olutsen1/IDOmeter/software/README_uk.md

# IDOmeter — програма: посібник користувача

Приймання даних із приладу (або симулятора), графіки в реальному часі, мітки
інтервенцій клавішами, запис сесії та аналіз відповідей на мітки. Усе працює на
одному комп'ютері: без Raspberry Pi, MQTT-брокера і Grafana.

## Встановлення (один раз)

1. Встановіть Python 3.11 або новіший з python.org. Якщо інсталятор пропонує
   галочку **«Add python.exe to PATH»**, поставте її.
2. Запустіть `1_install.bat`.

**Linux (Ubuntu/Debian):** відкрийте термінал у теці `software/` і один раз
виконайте `./1_install.sh` (може запитати пароль, щоб встановити два системні
пакети). Далі замість `.bat` використовуйте `./2_demo_with_simulator.sh`,
`./3_receiver_real_device.sh` і `./4_analyze_last_session.sh`. Якщо увімкнено
брандмауер `ufw`, відкрийте порт приладу: `sudo ufw allow 5005/udp`.

## Спробувати без приладу

Запустіть `2_demo_with_simulator.bat`. Відкриються два вікна: консоль симулятора
і програма. Якщо Windows запитає про доступ Python до мережі, дозвольте для
приватних мереж.

Натисніть **R** (запис), потім ставте мітки клавішами **1…9**, **Пробіл**, **B**.
Симулятор з імовірністю 80 % «відповідає тілом»: через 1–2,5 с зростає
провідність шкіри, пульс сповільнюється, а потім пришвидшується, іноді —
глибокий вдих. Він також видає спонтанні відповіді, не пов'язані з мітками,
як справжнє тіло, і приблизно раз на дві хвилини — рух пальця (`--motion`, за хвилину).

## З приладом

Як залити прошивку — у `..\firmware\HOW_TO_FLASH_uk.md`. Потім запускайте
`3_receiver_real_device.bat`.

## Клавіші

| Клавіша | Дія |
|---|---|
| 1…9, Пробіл, B | мітка відповідного типу |
| N | нотатка: час фіксується в момент натискання N, далі пишете текст, Enter |
| Esc | скасувати нотатку |
| R | старт / стоп запису |
| F | заморозити прокручування (тоді графіки можна гортати мишею) |

Мітки, поставлені до натискання R, видно на графіках, але у файл вони не потрапляють.

## Аналіз

```
python analyze.py sessions\<тека>
python analyze.py sessions\<тека> --truth sim_truth.csv     (перевірка на симуляторі)
```

Результати — у `sessions\<тека>\analysis`: `overview.png` (уся сесія),
`responses.png` (відповіді, накладені за типами міток) і `responses.csv`.
Аналіз також рахує **випадковий рівень**: як часто «відповідь» трапляється у
вікнах без міток. Про ефект можна говорити лише тоді, коли частка відповідей на
мітки помітно вища за нього.

## Мова і назви міток

Мова задається в `config.json`: `"language": "en"` або `"language": "uk"`.
Відкрийте файл Блокнотом і змініть значення. Тексти лежать у теці `lang`.
Щоб додати мову, скопіюйте `lang/en.json`, наприклад, у `lang/de.json`,
перекладіть значення (залишаючи `{заповнювачі}`) і вкажіть `"language": "de"`.

Власні назви міток: додайте до `config.json`
`"markers": {"1": "Питання", "2": "Відображення", ...}`. Якщо цього розділу
немає, беруться стандартні назви вибраної мови.

## Артефакти пульсу

Якщо палець зрушив або датчик притиснули, удар може бути розпізнано хибно, і
пульс стрибає на одну точку (наприклад, 55 → 93 → 52). Такі інтервали
відкидаються: кожен міжударний інтервал порівнюється із середнім двох сусідніх,
і найбільш відмінний відкидається, якщо різниця понад 30 %; перевірка
повторюється, доки таких не залишиться. Справжні зміни, навіть великі (реакція
переляку, коливання ±20 уд/хв під час повільного глибокого дихання), змінюються
поступово від удару до удару і зберігаються — це перевірено на синтетичних
випадках. Відкинутий удар видно як розрив лінії пульсу, а не як вигадане
значення. Сира PPG завжди записується повністю, а аналіз показує, скільки
інтервалів відкинуто; понад 10 % — попередження про поганий контакт датчика.

## Артефакти руху

Рух пальця або натиск на датчик видно в пульсовій хвилі як короткий сплеск,
набагато більший за звичайний (або як майже зникнення пульсу). Такі відрізки
зафарбовуються сірим на всіх графіках, а в панелі стану з'являється «рух».
Усередині них пульс і крива дихання з PPG не показуються, і вони не входять у
частоту дихання та у відповідь пульсу навколо міток. Провідність шкіри від цього
не залежить. Сирі дані записуються повністю; аналіз показує, скільки було
артефактів і якої тривалості, зафарбовує їх в `overview.png` і додає до
`responses.csv` стовпець `motion_s` (секунди руху у вікні кожної мітки).

Виявлення: локальний розмах пульсової хвилі (1,5 с) понад 3× або менше 0,15× від
його медіани за навколишню хвилину, **або** удар, форма якого корелює з типовою
формою сусідніх ударів менше ніж на 0,6 (легкий рух спотворює пульс, не
збільшуючи його), **або** сходинка базової лінії за два удари, більша за 2,5
розмаху пульсу (зміна тиску пальця); з розширенням на 1,5 с до і 2,5 с після.
Перед будь-якою обробкою поодинокі збої сирої PPG завдовжки 1–2 відліки
прибираються медіаною 50 мс (у запис потрапляють сирі значення). Пороги підібрано на
реальних записах так, щоб глибокі вдихи не позначалися (вони зсувають базову лінію
до 2,2 розмаху пульсу); із шести навмисних рухів пальцем позначено чотири, один не
залишив помітного сліду, ще один був легкою зміною тиску, що не заважає пульсу.
Нижня межа навмисно мала: після глибокого вдиху пульс пальця в нормі зменшується
до ~40 % на кілька секунд, і це фізіологія. Перевірка на симуляторі: усі рухи
виявлено; 5 хвилин з 10 глибокими вдихами без руху — жодної хибної смуги.

## Дихання без датчика

Якщо прилад не надсилає канал дихання (на нинішній платі його немає), графік
«Дихання» показує дихання, **оцінене за пульсовою хвилею** (з позначкою «з PPG»),
а панель стану — частоту дихання. Кожен вдих зсуває базову лінію PPG пальця;
`breathing.py` виділяє цей ритм (8–36 вдихів за хвилину). Видно ритм, паузи й
глибокі вдихи, але не об'єм дихання; чи йде вдих угору, чи вниз, залежить від людини.

**Частота** дихання рахується вдих за вдихом у трьох сигналах і зводиться
разом: зсув базової лінії, пульс (на вдиху він зростає) та амплітуда пульсової
хвилі. Два останні не залежать від повільного дрейфу базової лінії. На
синтетичних даних похибка близько 1 вдиху за хвилину; дихання, повільніше за
~8 за хвилину, — на межі діапазону й оцінюється завищено. Якщо три сигнали не
узгоджуються, замість частоти показується «—».

`"breathing_source"` у `config.json`: `"auto"` (типово: датчик, якщо є, інакше PPG),
`"sensor"` або `"ppg"`. Аналіз показує частоту дихання з PPG, а за наявності
датчика — наскільки вони збігаються.

## Калібрування EDA

### Калібрування резисторами (з підказками)

Залийте на плату `tools/board_check`, закрийте Serial Monitor в Arduino IDE і
запустіть `5_calibrate.bat` (Linux: `./5_calibrate.sh`). Програма сама знайде
порт плати, підкаже, який резистор під'єднати (1 МОм, 470 кОм, 220 кОм,
100 кОм, 47 кОм), запише кожен автоматично і збереже все в
`calibration/<дата_час>/` (`summary.csv`, `samples.csv`, сирий вивід плати і
текст з екрана). На запиті можна ввести виміряне значення резистора в кОм,
`s` — пропустити, `q` — завершити. У Linux для доступу до порту може знадобитися
один раз `sudo usermod -a -G dialout $USER` (потім вийти й увійти).

У `config.json`, розділ `eda_calibration`:

- `{"type": "relative", "full_scale": 65520, "invert": true}` — типово для
  Grove GSR: 0–100 відносних одиниць, угору = провідність зростає;
- `{"type": "table", "points": [[сире, мкСм], ...]}` — після калібрування на резисторах;
- `{"type": "linear", "gain": 0.001, "offset": 0}` — автоматично з симулятором.

## Файли

| Файл | Призначення |
|---|---|
| `protocol.py` | формат пакета (прошивка реалізує той самий) |
| `clocksync.py` | зведення годинників приладу і комп'ютера |
| `simulator.py` | симулятор приладу (`python simulator.py --help`) |
| `receiver.py`, `receiver_core.py` | програма |
| `analyze.py` | аналіз сесії |
| `i18n.py`, `lang/` | мови інтерфейсу |
| `config.json` | налаштування |

Сесія — це тека з `fast.csv` (PPG 100 Гц), `slow.csv` (EDA і дихання 20 Гц),
`markers.csv`, `packets.csv` (для точного перерахунку часу) і `meta.json`.
Усе відкривається в Excel або Python.

## Як влаштований час

Прилад не знає реального часу. Кожен пакет має номер і показ власного лічильника
мікросекунд. Програма фіксує момент надходження пакета і за **нижньою обвідною**
затримок будує пряму «час приладу → час комп'ютера» з урахуванням дрейфу кварцу.
Мітки ставляться за годинником комп'ютера, тож сигнали й мітки лежать на одній
шкалі з точністю до мілісекунд.
