olutsen1/IDOmeter/software/simulator.py

"""
IDometer device simulator ("a body in a box").

Generates realistic signals and sends them using protocol v1 (protocol.py),
just as the real device does:

  * skin conductance: a slow tonic level + phasic responses (SCRs),
    including spontaneous ones unrelated to any event;
  * PPG (MAX30102, IR and red) with heart rate, respiratory arrhythmia and noise;
  * breathing.

It also imitates the real device's imperfections: its own clock with drift
and a random initial offset, Wi-Fi delays and stalls, packet loss.

Most importantly, the simulator listens for the receiver's markers (port 5006)
and, with a given probability, "responds bodily": an SCR 1–2.5 s later, a heart
rate dip then rise, sometimes a deep breath. All planted responses are written
to sim_truth.csv in DEVICE time, so the analysis can check whether it finds
what was planted.

Run:  python simulator.py
         python simulator.py --help
"""
import argparse
import csv
import heapq
import math
import queue
import random
import socket
import threading
import time

import numpy as np

import i18n
import protocol as P
from i18n import tr


# ---------------------------------------------------------------- physiology

def _bateman_peak(tr, td):
    xs = np.linspace(0, 20, 20001)
    return float(np.max(np.exp(-xs / td) - np.exp(-xs / tr)))


class Body:
    TAU_RISE = 0.75
    TAU_DECAY = 2.5

    def __init__(self, rng: random.Random, spont_per_min=2.0, motion_per_min=0.0):
        self.rng = rng
        self.spont_rate = spont_per_min / 60.0
        self._norm = _bateman_peak(self.TAU_RISE, self.TAU_DECAY)
        self.tonic = 5.0
        self.tonic_target = 5.0
        self.scrs = []                  # (onset_s, amp_uS)
        self.hr_events = []             # onset_s
        self.sighs = []                 # onset_s
        self.motion_rate = motion_per_min / 60.0
        self.motion = []                # (onset_s, duration_s, amplitude, frequency_hz)
        self.resp_phase = 0.0
        self.resp_rate = 14.0
        self.hr_noise = 0.0
        self.ppg_drift = 0.0            # slow baseline wander of the finger PPG
        self.beats = []
        self.next_beat = None
        self.new_beats = []             # for the log
        self.t_last = None

    # --- events
    def add_scr(self, onset, amp):
        self.scrs.append((onset, amp))

    def add_hr_response(self, onset):
        self.hr_events.append(onset)

    def add_sigh(self, onset):
        self.sighs.append(onset)

    # --- components
    def _bateman(self, x):
        if x <= 0:
            return 0.0
        return (math.exp(-x / self.TAU_DECAY) - math.exp(-x / self.TAU_RISE)) / self._norm

    def eda(self, t):
        v = self.tonic
        for on, a in self.scrs:
            v += a * self._bateman(t - on)
        return v

    def _hr(self, t):
        hr = 68.0 + self.hr_noise + 4.0 * math.sin(self.resp_phase)
        for on in self.hr_events:
            x = t - on
            hr += -3.0 * math.exp(-0.5 * ((x - 1.5) / 0.7) ** 2)
            hr += 6.0 * math.exp(-0.5 * ((x - 5.0) / 1.6) ** 2)
        return hr

    def _resp_amp(self, t):
        a = 1.0
        for on in self.sighs:
            a += 0.9 * math.exp(-0.5 * ((t - on - 1.5) / 1.2) ** 2)
        return a

    @staticmethod
    def _pulse(x):
        if x < 0 or x > 1.0:
            return 0.0
        return (math.exp(-0.5 * ((x - 0.18) / 0.055) ** 2)
                + 0.35 * math.exp(-0.5 * ((x - 0.42) / 0.07) ** 2))

    # --- 10 ms step
    def _motion(self, t):
        """Finger movement: a burst much larger than the pulse, plus a baseline push."""
        m = 0.0
        for on, dur, a, f in self.motion:
            x = t - on
            if 0 <= x <= dur:
                env = math.sin(math.pi * x / dur)
                m += a * env * (math.sin(2 * math.pi * f * x) + 0.5)
        return m

    def _vasoconstriction(self, t):
        """After a deep breath the finger pulse shrinks to ~45 % for several seconds."""
        v = 0.0
        for on in self.sighs:
            v += 0.55 * math.exp(-0.5 * ((t - on - 6.0) / 2.5) ** 2)
        return max(0.3, 1.0 - v)

    def step(self, t, slow: bool, spont_cb=None, motion_cb=None):
        dt = 0.0 if self.t_last is None else t - self.t_last
        self.t_last = t
        # breathing
        self.resp_rate += (14.0 - self.resp_rate) * dt / 30 + self.rng.gauss(0, 0.3) * math.sqrt(max(dt, 0))
        self.resp_phase += 2 * math.pi * self.resp_rate / 60.0 * dt
        # slow heart-rate noise
        self.hr_noise += -self.hr_noise * dt / 20 + self.rng.gauss(0, 0.6) * math.sqrt(max(dt, 0))
        self.ppg_drift += -self.ppg_drift * dt / 30 + self.rng.gauss(0, 60) * math.sqrt(max(dt, 0))
        # beats
        if self.next_beat is None:
            self.next_beat = t
        while self.next_beat <= t:
            self.beats.append(self.next_beat)
            self.new_beats.append(self.next_beat)
            self.next_beat += 60.0 / self._hr(self.next_beat)
        self.beats = [b for b in self.beats if t - b < 1.2]
        pulse = sum(self._pulse(t - b) for b in self.beats)
        resp = self._resp_amp(t) * math.sin(self.resp_phase)
        # A real finger PPG: a weak breathing baseline (RIIV), pulse amplitude
        # modulated by breathing, ~0.1 Hz vasomotor (Mayer) waves and slow drift.
        mayer = 150 * math.sin(2 * math.pi * 0.1 * t)
        amp = (1 + 0.08 * resp) * self._vasoconstriction(t)
        if self.motion_rate and self.rng.random() < self.motion_rate * dt:
            dur = self.rng.uniform(0.5, 2.0)
            if self.rng.random() < 0.5:     # gentle: pulse-sized, distorts the shape
                kind, a, f = "gentle", self.rng.uniform(800, 2500), self.rng.uniform(2.0, 5.0)
            else:                           # strong: a burst far above the pulse
                kind, a, f = "strong", self.rng.uniform(4000, 12000), self.rng.uniform(0.7, 3.0)
            self.motion.append((t, dur, a * self.rng.choice((-1, 1)), f))
            if motion_cb:
                motion_cb(t, t + dur, kind)
        self.motion = [mv for mv in self.motion if t - mv[0] < mv[1] + 0.1]
        mot = self._motion(t)
        ir = 120000 + self.ppg_drift + mayer + mot + 150 * resp - 1300 * amp * pulse + self.rng.gauss(0, 25)
        red = (95000 + 0.7 * (self.ppg_drift + mayer + mot) + 110 * resp - 900 * amp * pulse
               + self.rng.gauss(0, 25))

        eda = resp_out = None
        if slow:
            # tonic level: slow random walk
            if self.rng.random() < 0.002:
                self.tonic_target = min(12, max(2, self.tonic_target + self.rng.gauss(0, 0.8)))
            self.tonic += (self.tonic_target - self.tonic) * 0.05 / 60 + self.rng.gauss(0, 0.002)
            # spontaneous SCRs
            if self.rng.random() < self.spont_rate * 0.05:
                amp = self.rng.uniform(0.05, 0.25)
                self.add_scr(t, amp)
                if spont_cb:
                    spont_cb(t, amp)
            self.scrs = [(o, a) for o, a in self.scrs if t - o < 30]
            self.hr_events = [o for o in self.hr_events if t - o < 15]
            self.sighs = [o for o in self.sighs if t - o < 10]
            eda = self.eda(t) + self.rng.gauss(0, 0.008)
            resp_out = resp + self.rng.gauss(0, 0.02)
        return ir, red, eda, resp_out


# ---------------------------------------------------------------- Wi-Fi

class NetSender(threading.Thread):
    """Sending with delays, stalls and losses. Packet order is preserved."""

    def __init__(self, addr, rng, loss, jitter_ms, stall_every_s):
        super().__init__(daemon=True)
        self.addr = addr
        self.rng = rng
        self.loss = loss
        self.jitter = jitter_ms / 1000
        self.stall_every = stall_every_s
        self.sock = socket.socket(socket.AF_INET, socket.SOCK_DGRAM)
        self.heap = []
        self.cv = threading.Condition()
        self.last_send = 0.0
        self.stall_until = 0.0
        self.counter = 0
        self.lost = 0

    def submit(self, data: bytes, ready_t: float):
        if self.rng.random() < self.loss:
            self.lost += 1
            return
        if self.stall_every > 0 and self.rng.random() < 0.1 / self.stall_every:
            self.stall_until = ready_t + self.rng.uniform(0.3, 1.2)
        delay = 0.002 + self.rng.expovariate(1 / self.jitter) if self.jitter > 0 else 0.002
        send_at = max(ready_t + delay, self.last_send, self.stall_until)
        self.last_send = send_at
        with self.cv:
            heapq.heappush(self.heap, (send_at, self.counter, data))
            self.counter += 1
            self.cv.notify()

    def run(self):
        while True:
            with self.cv:
                while not self.heap:
                    self.cv.wait()
                send_at, _, data = self.heap[0]
                wait = send_at - time.perf_counter()
                if wait > 0:
                    self.cv.wait(timeout=wait)
                    continue
                heapq.heappop(self.heap)
            try:
                self.sock.sendto(data, self.addr)
            except OSError:
                pass


# ---------------------------------------------------------------- main loop

def main():
    ap = argparse.ArgumentParser(description="IDometer device simulator")
    ap.add_argument("--host", default="127.0.0.1", help="receiver address")
    ap.add_argument("--port", type=int, default=P.DATA_PORT)
    ap.add_argument("--feedback-port", type=int, default=P.SIM_FEEDBACK_PORT,
                    help="port where the simulator listens for markers")
    ap.add_argument("--p-response", type=float, default=0.8,
                    help="probability of a bodily response to a marker")
    ap.add_argument("--habituation", type=float, default=0.9,
                    help="amplitude factor for each repeat of the same marker type")
    ap.add_argument("--spont", type=float, default=2.0, help="spontaneous SCRs per minute")
    ap.add_argument("--drift-ppm", type=float, default=40.0, help="device clock drift")
    ap.add_argument("--jitter-ms", type=float, default=10.0, help="mean network delay")
    ap.add_argument("--stall-every", type=float, default=40.0,
                    help="Wi-Fi stalls on average every N seconds (0 = never)")
    ap.add_argument("--loss", type=float, default=0.005, help="fraction of lost packets")
    ap.add_argument("--truth", default="sim_truth.csv", help="log of planted responses")
    ap.add_argument("--duration", type=float, default=0, help="stop after N seconds")
    ap.add_argument("--motion", type=float, default=0.5,
                    help="finger movements per minute (motion artefacts in the PPG; 0 = none)")
    ap.add_argument("--seed", type=int, default=None)
    args = ap.parse_args()
    i18n.init_from_config()

    rng = random.Random(args.seed)
    body = Body(rng, args.spont, args.motion)
    net = NetSender((args.host, args.port), rng, args.loss, args.jitter_ms, args.stall_every)
    net.start()

    # device clock: its own initial offset and drift
    t_start = time.perf_counter()
    dev_offset = rng.uniform(5, 50)          # "the device was switched on N seconds ago"
    k_drift = 1 + args.drift_ppm * 1e-6

    def dev_us(t):
        return int(round(((t - t_start) * k_drift + dev_offset) * 1e6))

    # ground-truth log
    truth_f = open(args.truth, "w", newline="", encoding="utf-8")
    truth = csv.writer(truth_f)
    truth.writerow(["kind", "label", "stim_device_us", "onset_device_us", "scr_amp_uS",
                    "hr_response", "sigh", "end_device_us"])
    beats_f = open(args.truth.replace(".csv", "_beats.csv"), "w", newline="")
    beats = csv.writer(beats_f)
    beats.writerow(["beat_device_us"])

    def on_spont(t, amp):
        truth.writerow(["spontaneous", "", "", dev_us(t), f"{amp:.4f}", 0, 0, ""])

    def on_motion(t0, t1, kind):
        truth.writerow(["motion", kind, "", dev_us(t0), "", 0, 0, dev_us(t1)])

    # markers from the receiver
    marks = queue.Queue()

    def listen():
        s = socket.socket(socket.AF_INET, socket.SOCK_DGRAM)
        s.bind(("0.0.0.0", args.feedback_port))
        while True:
            data, _ = s.recvfrom(1024)
            if data.startswith(b"MARK"):
                marks.put((time.perf_counter(), data[5:].decode("utf-8", "replace")))
    threading.Thread(target=listen, daemon=True).start()

    label_counts = {}
    n = P.DEFAULT_TICKS_PER_PACKET
    block = n / P.BASE_RATE_HZ
    seq = 0
    print(tr("sim_start", host=args.host, port=args.port, fb=args.feedback_port))
    print(tr("sim_params", drift=args.drift_ppm, loss=args.loss, truth=args.truth))
    print(tr("sim_stop_hint"))
    try:
        while True:
            t_block = t_start + seq * block
            t_ready = t_block + block
            now = time.perf_counter()
            if t_ready > now:
                time.sleep(t_ready - now)
            if args.duration and t_ready - t_start > args.duration:
                break

            # handle markers that have arrived by now
            while not marks.empty():
                t_stim, label = marks.get()
                cnt = label_counts.get(label, 0)
                label_counts[label] = cnt + 1
                if rng.random() < args.p_response:
                    onset = t_stim + rng.uniform(1.0, 2.5)
                    amp = rng.uniform(0.2, 0.8) * args.habituation ** cnt
                    sigh = rng.random() < 0.4
                    body.add_scr(onset, amp)
                    body.add_hr_response(t_stim)
                    if sigh:
                        body.add_sigh(t_stim)
                    truth.writerow(["response", label, dev_us(t_stim), dev_us(onset),
                                    f"{amp:.4f}", 1, int(sigh), ""])
                else:
                    truth.writerow(["no_response", label, dev_us(t_stim), "", "", 0, 0, ""])
                truth_f.flush()

            ir = np.zeros(n, np.int64)
            red = np.zeros(n, np.int64)
            eda = []
            resp = []
            for i in range(n):
                t = t_block + i / P.BASE_RATE_HZ
                slow = (i % P.SLOW_DIV) == 0
                a, b, e, r = body.step(t, slow, on_spont, on_motion)
                ir[i], red[i] = a, b
                if slow:
                    eda.append(round(e * 1000))       # nS
                    resp.append(round(r * 1000))
            for bt in body.new_beats:
                beats.writerow([dev_us(bt)])
            body.new_beats.clear()

            pkt = P.DataPacket(seq, dev_us(t_block), n, P.FLAG_FINGER,
                               ir, red, np.array(eda), np.array(resp))
            net.submit(P.encode(pkt), t_ready)
            seq += 1
            if seq % 100 == 0:
                truth_f.flush()
                beats_f.flush()
    except KeyboardInterrupt:
        pass
    finally:
        truth_f.close()
        beats_f.close()
        print(tr("sim_done", n=seq, lost=net.lost))


if __name__ == "__main__":
    main()
