olutsen1/IDOmeter/(commit log)

2026-10-29 IDOmeter 2: new firmware, desktop app, Wi-Fi setup, legacy archive
    - software/: Python app replacing Raspberry Pi + Mosquitto + Grafana:
    UDP receiver with clock alignment, live plots, intervention markers,
    session recording, response analysis with chance level, device simulator
    - firmware/IDometer_fw: ESP32 core 3.x firmware for TTGO T-Display;
    hardware-timer sampling (PPG 100 Hz, EDA 20 Hz), numbered packets with
    device timestamps, no NTP; Wi-Fi setup from phone or serial, SD backup
    - legacy/: original prototype firmware and dummy generator (placeholders
    instead of credentials)
    - English README with not-a-medical-device notice; .gitignore keeps
    session recordings out of git
    Co-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
2026-10-29 English interface with switchable languages; firmware 2.2 in English
    - software: all user-visible text moved to lang/en.json and lang/ru.json
    (i18n.py); "language" in config.json selects it, English by default;
    default marker names follow the language unless set in config.json
    - firmware 2.2: serial messages and the phone Wi-Fi setup page in English;
    config.h comments in English
    - docs: English user guide (software/README.md) and flashing guide
    (firmware/HOW_TO_FLASH.md); Russian versions kept
    Claude-Session: https://claude.ai/code/session_01662p8PJ99ssxo6LCfs1k4i
2026-10-29 Add hardware wiring diagram and connection table
    - hardware/wiring.svg: module-level wiring of the V1.0 board, traced from
    the PCB photos and firmware, with the planned ADS1115 shown dashed
    - hardware/README.md: connection table and ADS1115 hookup with the
    3.3 V check before first power-up
    - tools/make_wiring.py: generator for the diagram
    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
2026-10-29 Add a conventional schematic of the V1.0 board
    - hardware/schematic.svg: modules as blocks with all header pins, net
    labels for buses and power, unused pins marked not connected; ADS1115
    shown in grey as planned (DNP)
    - tools/make_schematic.py: generator (schemdraw)
    - hardware/README.md: schematic first, rail diagram kept as an overview
    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
2026-10-29 Estimate breathing from the PPG when there is no breathing sensor
    - software/breathing.py: breathing rhythm from the finger PPG baseline
    (RIIV), 10 Hz, band 0.13–0.6 Hz (8–36 /min, above Mayer waves), plus a
    breathing-rate estimate with a quality score
    - receiver: Breathing plot shows the PPG estimate ("from PPG") when the
    device sends no breathing channel; breathing rate in the status panel;
    "breathing_source" setting: auto / sensor / ppg
    - analyze: PPG breathing in overview.png, median breathing rate, and
    agreement with a breathing sensor when one is present
    - simulator: more realistic PPG (weaker breathing baseline, pulse amplitude
    modulation, Mayer waves, slow drift); PPG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
2026-10-29 PPG breathing: cancel the heartbeat before filtering
    At a low heart rate (45–55 bpm) the pulse leaked through the breathing
    band: the breathing curve oscillated once per heartbeat. A moving average
    exactly one beat long, applied twice, now removes the heartbeat and its
    harmonics before the 0.13–0.6 Hz band-pass (now 3rd order). The beat length
    comes from the spectral peak of the PPG. Breathing-rate resolution improved
    by zero-padding the spectrum.
    Synthetic test with a weak breathing baseline: correlation with true
    breathing at 45/50/55 bpm rose from 0.34/0.40/0.46 to 0.78/0.76/0.74;
    simulator session: 0.92, rate 15 vs 15 /min.
    Cl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
2026-10-29 Reject heart-rate artefacts from misdetected beats
    A finger movement during a deep breath produced a one-point spike
    (55 -> 93 -> 52 bpm). Each beat interval is now compared with the mean of
    its two neighbours; the worst one is rejected if it differs by more than
    30 %, repeating until none does. Live, the decision on a beat is revisited
    until its right-hand neighbour arrives (window of 40 intervals).
    Checked on synthetic cases: no rejections for resting RSA, ±20 bpm swings
    during slow deep breathing, a +25 bpm startle, orienting dip/rise, or beat
    jitter; extra beats, missed beats and the observed spike are all caught.
    A window-median rule was tried first and rejected 30 % of real beats dur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
2026-10-29 Breathing rate: count breaths in three PPG modulations and fuse
    The spectral breathing-rate estimate stuck near the lower band edge on a
    real recording (always 8 /min, actual breathing faster): slow baseline drift
    dominated the single baseline (RIIV) signal.
    Now each breath is counted (advanced counting, Schäfer & Kratky 2008) in
    three modulations: baseline (RIIV), heart rate (RIFV, from cleaned beat
    intervals) and pulse amplitude (RIAV), and fused (Karlen et al. 2013): RIFV
    and RIAV first, RIIV as tie-breaker. 60 s window; "—" when they disagree.
    Synthetic check (HR 50/56/70, breathing 8–24 /min, drift, Mayer waves):
    mean |error| spectral 4.6 -> fused 0.9 breaths/min. Breathing < ~8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
2026-10-29 Detect motion artefacts in the PPG and keep them out of the results
    A finger movement produced a PPG burst that appeared in the breathing curve
    as a convincing "deep breath" and squashed the PPG plot scale.
    - software/motion.py: local pulse-wave range (1.5 s, 0.5–5 Hz) above 3x or
    below 0.15x its median over the surrounding minute; widened 1.5 s before
    and 2.5 s after. The low limit stays small so post-deep-breath finger
    vasoconstriction (pulse down to ~40 %) is not flagged.
    - receiver: grey bands on all plots, "movement" in the status panel; heart
    rate and PPG breathing hidden inside them; breathing rate from the longest
    clean stretch (>= 30 s) of the last minute; PPG scale fro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
2026-10-30 Motion detection: also check each beat's shape
    A gentle finger movement on a real recording distorted the pulse (extra
    small peaks) without making it larger, so the amplitude test missed it and
    two adjacent bad intervals (92 and 120 bpm) shielded each other from beat
    rejection.
    Each beat's waveform (-0.35..+0.45 s around the peak, amplitude-normalised)
    is now correlated with the median shape of the surrounding 30 beats; below
    0.75 the beat is flagged as movement. Amplitude normalisation keeps
    vasoconstriction after deep breaths unflagged. Heart-rate intervals inside
    the flagged stretch are hidden as before.
    Simulator (gentle pulse-sized and strong movements, 3/min, 5 min):
    gentle 5/7 -> 7/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
2026-10-30 Motion detection tuned on a real recording; PPG despike; baseline steps
    Real recording, 53 s, six deliberate finger movements:
    - clean-beat shape correlation 0.94-1.00, so the 0.75 shape threshold has
    a wide margin on a real finger;
    - one movement was a fast baseline step (finger pressure) with unchanged
    beat shape: now detected as a change of the beat-foot level over two beats
    above 1.0 pulse amplitude (step measured 1.35; quiet breathing <= 0.56);
    - one movement left no visible trace and is correctly not flagged;
    result: 5 of 6 flagged (amplitude-only version: 3 of 6).
    - the raw PPG has 2-sample out-of-place values every ~4.4 s in both LED
    channels (sensor link); a 5-point median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
2026-10-30 Status panel: cards, vital tiles and chips instead of a text block
    The top of the side panel was one rich-text label. It is now:
    - a connection card: coloured dot, state and device address; packets/s,
    losses and clock sync in small grey text below;
    - two tiles with large numbers: heart rate and breathing (breathing only
    when it is derived from the PPG), coloured like their plot lines;
    - chips: finger on sensor (green / red), movement (amber, only while
    present), recording time (red, only while recording).
    Nothing else in the window changed.
    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
2026-10-31 Add an ADS1115 module check sketch
    Standalone Arduino sketch (Uno/Nano or ESP32, no libraries) that tells a
    genuine 16-bit ADS1115 from a fake: conversion time at the slowest data
    rate (125 ms vs ~8 ms for an ADS1015), use of the lowest 4 bits, register
    read-back, input multiplexer and accuracy (A0 on 3.3 V, A1 on GND).
    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
2026-10-31 Add an I2C scanner sketch (tries both SDA/SCL orders, reports idle line levels)
    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
2026-10-31 Add board_check sketch: GSR node read by ESP32 and ADS1115 side by side
    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
2026-11-02 Motion detection: do not flag deep breaths
    Three real recordings show that the baseline-step criterion (1.0 pulse
    amplitude) fired on deep breaths, which shift the PPG baseline by up to 2.2
    pulse amplitudes within two beats; the shape check fired twice at 0.69-0.71.
    Deliberate finger movements gave steps of 2.3-7.4 and shape 0.06-0.62.
    STEP_MAX 1.0 -> 2.5, SHAPE_MIN 0.75 -> 0.6:
    - deep-breath sessions: 26 s and 41 s flagged -> 0 s and 5 s;
    - movement session: 4 of 6 flagged (was 5); the one dropped is a slight
    pressure step that leaves heart rate intact;
    - simulator: strong 4/4, gentle 3/3, 0 false segments (unchanged).
    Claude-Sessi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
2026-11-02 Hardware: photos of the V1.0 board with the ADS1115 fitted
    Three example photos (component side, with the pulse sensor, copper side),
    cropped, colour-balanced and resized to 1400 px. README: photo section,
    ADS1115 marked as fitted, note on the reverted 5 V experiment.
    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
2026-11-02 Hardware drawings: ADS1115 fitted
    Schematic and wiring regenerated: U5 ADS1115 drawn as a fitted part (no
    longer grey/dashed); Grove SIG goes to both ESP32 GPIO36 and ADS1115 A0;
    A1 noted as reserved for a breathing sensor. README text updated.
    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
2026-11-04 Guided resistor calibration program (calibrate.py)
    Reads the board_check output over the serial port, prompts for each resistor
    (1M, 470k, 220k, 100k, 47k), records every step by itself (2 s settling,
    12 s hold, 8 s open after each) with a live readout, flags unstable contacts
    and offers a repeat, and saves calibration/<date_time>/ with summary.csv,
    samples.csv, the board's raw output and the console text. Port found
    automatically (CH340/CH9102, CP210x, Espressif, FTDI) or chosen. Measured
    resistor values can be typed in kOhm. en/uk strings, 5_calibrate.bat/.sh,
    pyserial added to requirements. Tested against a simulated board.
    Claude-S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
2026-11-07 Firmware: detailed comments throughout (code unchanged)
    Explains the data flow (timer -> sampler -> queue -> sender), why tasks and
    priorities, the PPG ring buffer, packet layout byte by byte, broadcast/IDHI
    discovery, SD flushing, screen fields and diagnostics, sensor and timer
    set-up arguments, and the Wi-Fi task's connect / setup-mode logic.
    Comment lines: IDometer_fw.ino 56 -> 192, wifi_setup.h 26 -> 68,
    config.h 20 -> 22. Verified: comment-stripped code identical; compiles.
    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
